htfab/breakout-ttgf0p1-adapter/README.md

# Tiny Tapeout GF 0p1 COB to ETR adapter PCB

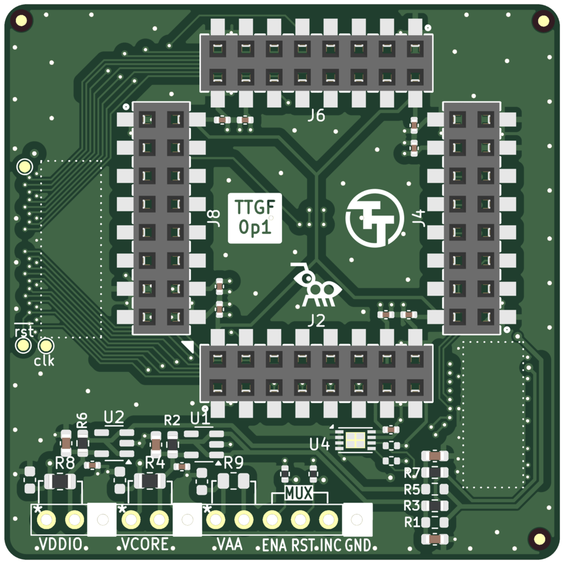
[picture p1: images/top.png]
&emsp;
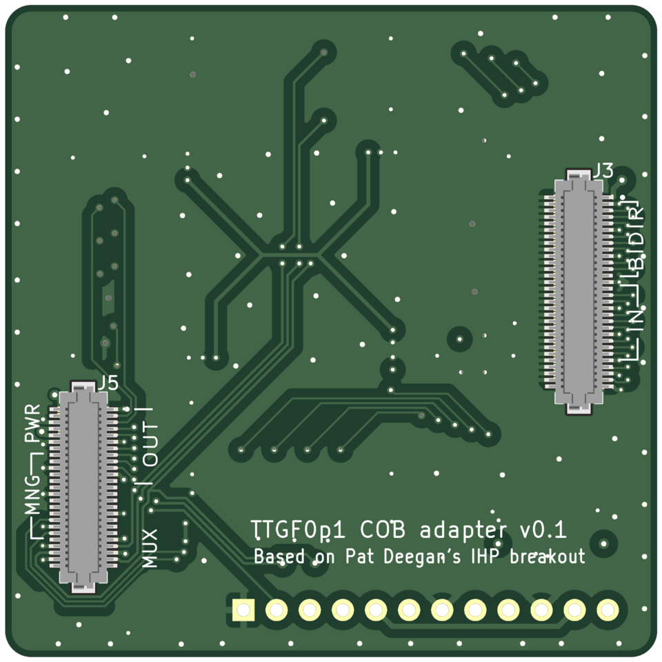
[picture p2: images/bottom.png]
