htfab/breakout-ttgf0p1-adapter/production/bom.csv

Designator | Footprint | Quantity | Value | LCSC Part #
C1, C2, C5, C6 | 0603 | 4 | 10uF
C10, C11, C12, C13, C14, C15, C16, C17 | 0402 | 8 | 1uF | CL05A105KO5NNNC
C18, C3, C7 | 0402 | 3 | 100nF | C100072
J2, J4, J6, J8 | HDR-SMD_16P-P2.54-V-F-R2-C8-LS7.2_H5.0 | 4 | Conn_02x08_Odd_Even | C42163136
J3 | HRS_DF12NB-60DS-0.5V_51 | 1 | DF12NB-60DS-0.5V_51 | C5137127
J5 | HRS_DF12NB-50DS-0.5V_51 | 1 | DF12NB-50DS-0.5V_51 | C2858672
R10, R11 | 0402 | 2 | 1kΩ | C11702
R2, R3, R6, R7 | 0603 | 4 | 0Ω | C21189
R4, R8 | 0805 | 2 | 0Ω | C17477
