htfab/breakout-ttgf0p1-adapter/breakout-ttgf0p1-adapter.kicad_sch

## KiCad design breakout-ttgf0p1-adapter.kicad_sch (2026-04-04)

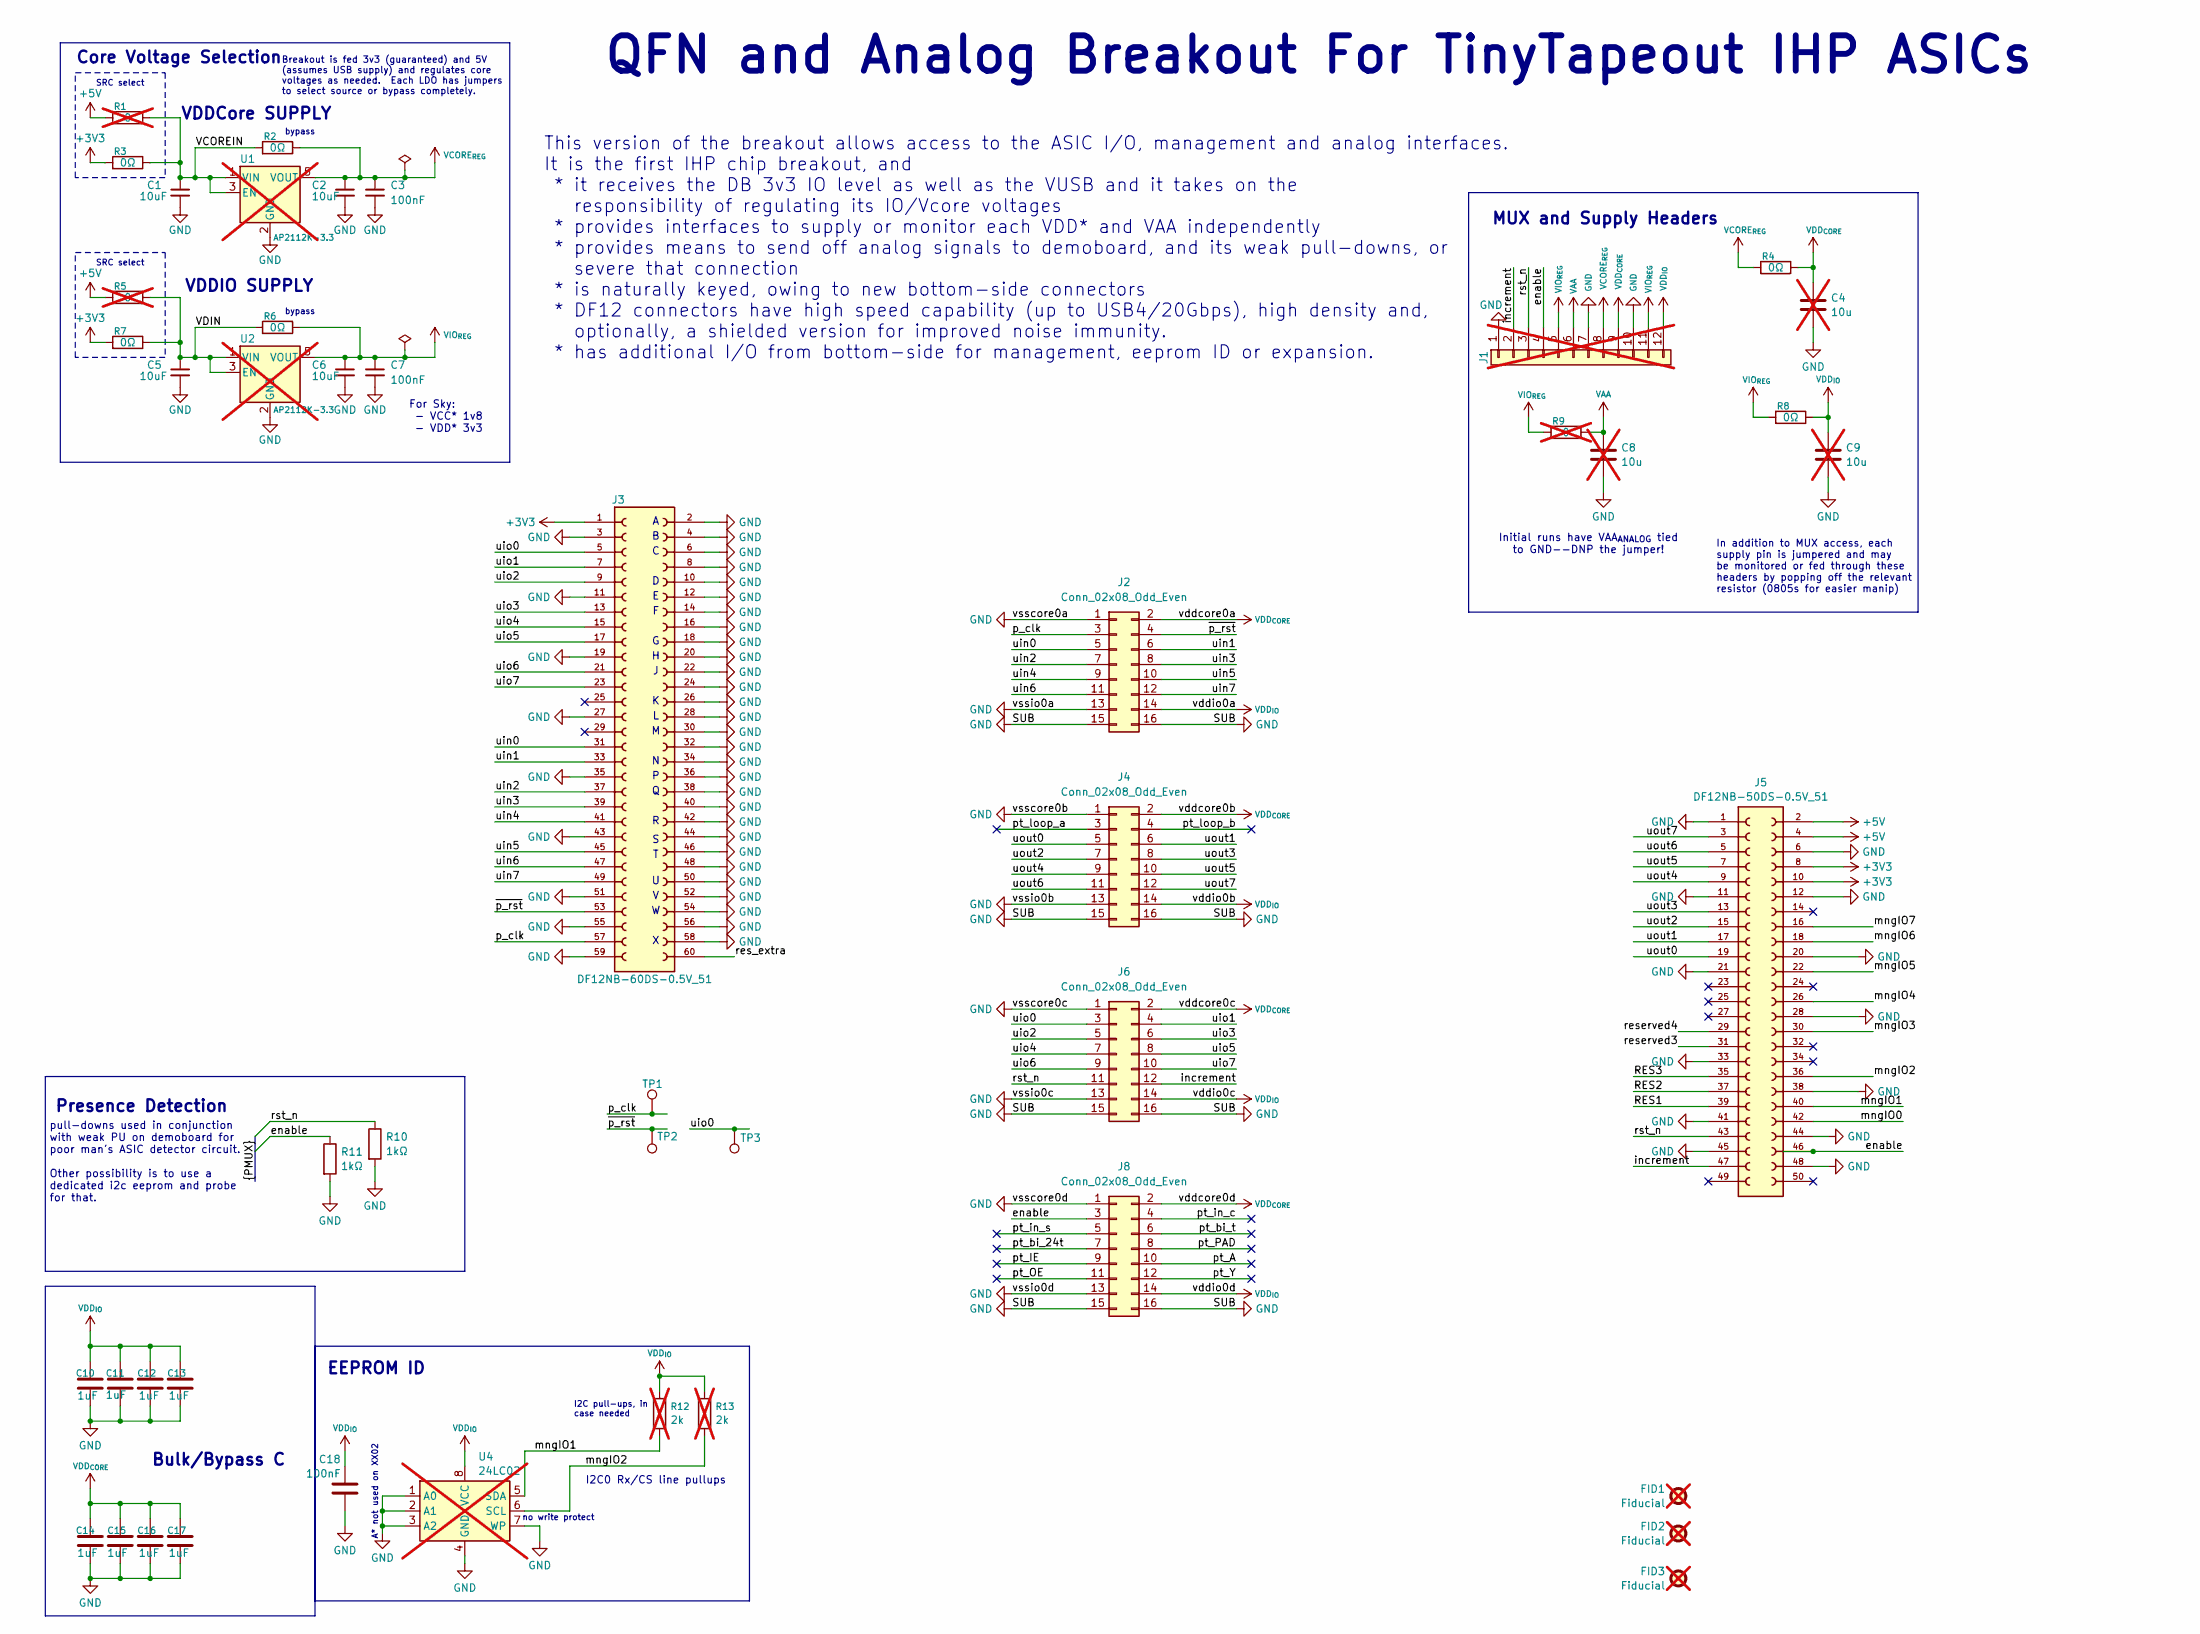
[picture p3: schematic breakout-ttgf0p1-adapter.kicad_sch]

Parts:
C1, C5: 10uF; C_0603_1608Metric; MPN_ALT LMK212AB7106MG-T
C2, C6: 10uF; C_0603_1608Metric; MPN_ALT C0603C105K4RAC7411
C3, C7, C18: 100nF; C_0402_1005Metric; MPN CL05A104KA5NNNC; LCSC C100072
C4, C8, C9: 10uF; C_0603_1608Metric; MPN GRT188R61H105KE13D; DigikeyPN 490-12330-1-ND; not fitted
C10, C11, C12, C13, C14, C15, C16, C17: 1uF; C_0402_1005Metric; MPN CL05A105KO5NNNC; DigikeyPN 1276-1067-1-ND
FID1, FID2, FID3: Fiducial; Fiducial_1mm_Mask2mm; not fitted
J1: Conn_01x12; PinHeader_1x12_P2.54mm_Vertical; not fitted
J2, J4, J6, J8: Conn_02x08_Odd_Even; HDR-SMD_16P-P2.54-V-F-R2-C8-LS7.2_H5.0
J3: DF12NB-60DS-0.5V_51; HRS_DF12NB-60DS-0.5V_51; MPN DF12NB-60DS-0.5V(51); DigikeyPN 26-DF12NB-60DS-0.5V(51)CT-ND
J5: DF12NB-50DS-0.5V_51; HRS_DF12NB-50DS-0.5V_51; MPN DF12NB-50DS-0.5V(51); DigikeyPN 26-DF12NB-50DS-0.5V(51)CT-ND
R1, R5: 0; R_0603_1608Metric; MPN CRG0603ZR; DigikeyPN A106051CT-ND; not fitted
R2, R3, R6, R7: 0Ω; R_0603_1608Metric; MPN CRG0603ZR; DigikeyPN A106051CT-ND
R4, R8: 0Ω; R_0805_2012Metric; MPN RC0805JR-100RL; DigikeyPN 13-RC0805JR-100RLCT-ND
R9: 0; R_0805_2012Metric; MPN RC0805JR-100RL; DigikeyPN 13-RC0805JR-100RLCT-ND; not fitted
R10, R11: 1kΩ; R_0402_1005Metric; MPN CR0402-FX-1001GLF; LCSC C11702
R12, R13: 2k; R_0402_1005Metric; MPN RC0402FR-072KL; DigikeyPN 311-2KLRCT-ND; not fitted
TP1, TP2, TP3: TestPoint; TestPoint_Pad_D1.0mm
U1, U2: AP2112K-3.3; SOT-23-5; MPN AP2112K-3.3TRG1; DigikeyPN AP2112K-3.3TRG1DICT-ND; not fitted
U4: 24LC02; DFN-8-1EP_3x2mm_P0.5mm_EP1.75x1.45mm; MPN 24LC02BT-I/MC; DigikeyPN 24LC02BT-I/MCCT-ND; not fitted

Connections:
+3V3: J3.1, J5.8, J5.10, R3.1, R7.1
+5V: J5.2, J5.4, R1.1, R5.1
GND: C1.2, C2.2, C3.2, C4.2, C5.2, C6.2, C7.2, C8.2, C9.2, C10.2, C11.2, C12.2, C13.2, C14.2, C15.2, C16.2, C17.2, C18.1, J1.1, J1.7, J1.10, J2.1, J2.13, J2.15, J2.16, J3.2, J3.3, J3.4, J3.6, J3.8, J3.10, J3.11, J3.12, J3.14, J3.16, J3.18, J3.19, J3.20, J3.22, J3.24, J3.26, J3.27, J3.28, J3.30, J3.32, J3.34, J3.35, J3.36, J3.38, J3.40, J3.42, J3.43, J3.44, J3.46, J3.48, J3.50, J3.51, J3.52, J3.54, J3.55, J3.56, J3.58, J3.59, J4.1, J4.13, J4.15, J4.16, J5.1, J5.6, J5.11, J5.12, J5.20, J5.21, J5.28, J5.33, J5.38, J5.41, J5.44, J5.45, J5.48, J6.1, J6.13, J6.15, J6.16, J8.1, J8.13, J8.15, J8.16, R10.2, R11.2, U1.2 (GND), U2.2 (GND), U4.1 (A0), U4.2 (A1), U4.3 (A2), U4.4 (GND), U4.7 (WP)
RES1: J5.39
RES2: J5.37
RES3: J5.35
VAA: C8.1, J1.6, R9.2
VCOREIN: C1.1, R1.2, R2.1, R3.2, U1.1 (VIN), U1.3 (EN)
VCORE_{REG}: C2.1, C3.1, J1.8, R2.2, R4.1, U1.5 (VOUT)
VDD_{CORE}: C4.1, C14.1, C15.1, C16.1, C17.1, J1.9, J2.2, J4.2, J6.2, J8.2, R4.2
VDD_{IO}: C9.1, C10.1, C11.1, C12.1, C13.1, C18.2, J1.12, J2.14, J4.14, J6.14, J8.14, R8.2, R12.1, R13.1, U4.8 (VCC)
VDIN: C5.1, R5.2, R6.1, R7.2, U2.1 (VIN), U2.3 (EN)
VIO_{REG}: C6.1, C7.1, J1.5, J1.11, R6.2, R8.1, R9.1, U2.5 (VOUT)
enable: J1.4, J5.46, J8.3, R11.1
increment: J1.2, J5.47, J6.12
mngIO0: J5.42
mngIO1: J5.40, R12.2, U4.5 (SDA)
mngIO2: J5.36, R13.2, U4.6 (SCL)
mngIO3: J5.30
mngIO4: J5.26
mngIO5: J5.22
mngIO6: J5.18
mngIO7: J5.16
p_clk: J2.3, J3.57, TP1.1
pt_A: J8.10
pt_IE: J8.9
pt_OE: J8.11
pt_PAD: J8.8
pt_Y: J8.12
pt_bi_24t: J8.7
pt_bi_t: J8.6
pt_in_c: J8.4
pt_in_s: J8.5
pt_loop_a: J4.3
pt_loop_b: J4.4
res_extra: J3.60
reserved3: J5.31
reserved4: J5.29
rst_n: J1.3, J5.43, J6.11, R10.1
uin0: J2.5, J3.31
uin1: J2.6, J3.33
uin2: J2.7, J3.37
uin3: J2.8, J3.39
uin4: J2.9, J3.41
uin5: J2.10, J3.45
uin6: J2.11, J3.47
uin7: J2.12, J3.49
uio0: J3.5, J6.3, TP3.1
uio1: J3.7, J6.4
uio2: J3.9, J6.5
uio3: J3.13, J6.6
uio4: J3.15, J6.7
uio5: J3.17, J6.8
uio6: J3.21, J6.9
uio7: J3.23, J6.10
uout0: J4.5, J5.19
uout1: J4.6, J5.17
uout2: J4.7, J5.15
uout3: J4.8, J5.13
uout4: J4.9, J5.9
uout5: J4.10, J5.7
uout6: J4.11, J5.5
uout7: J4.12, J5.3
~p_rst: J2.4, J3.53, TP2.1

Notes on the sheet:
Presence Detection
Bulk/Bypass C
I2C pull-ups, in case needed
pull-downs used in conjunction with weak PU on demoboard for poor man's ASIC detector circuit. Other possibility is to use a dedicated i2c eeprom and probe for that.
For Sky: - VCC* 1v8 - VDD* 3v3
Breakout is fed 3v3 (guaranteed) and 5V (assumes USB supply) and regulates core voltages as needed. Each LDO has jumpers to select source or bypass completely.
I2C0 Rx/CS line pullups
A* not used on XX02
MUX and Supply Headers
bypass
Initial runs have VAA_{ANALOG} tied to GND--DNP the jumper!
VDDCore SUPPLY
SRC select
In addition to MUX access, each supply pin is jumpered and may be monitored or fed through these headers by popping off the relevant resistor (0805s for easier manip)
VDDIO SUPPLY
no write protect
This version of the breakout allows access to the ASIC I/O, management and analog interfaces. It is the first IHP chip breakout, and * it receives the DB 3v3 IO level as well as the VUSB and it takes on the responsibility of regulating its IO/Vcore voltages * provides interfaces to supply or monito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
Core Voltage Selection
EEPROM ID
QFN and Analog Breakout For TinyTapeout IHP ASICs
