htfab/breakout-ttgf0p1-adapter/(commit log)

2026-03-18 initial version
    [breakout-ttgf0p1-adapter.kicad_pcb, breakout-ttgf0p1-adapter.kicad_sch]
2026-03-18 remove cob symbol & footprint
2026-03-19 add tillitis logo
    [breakout-ttgf0p1-adapter.kicad_pcb]
2026-03-19 don't remove duplicate track
    [breakout-ttgf0p1-adapter.kicad_pcb]
2026-03-19 add board images
2026-03-19 add production files
    [bom.csv, designators.csv, positions.csv]
2026-03-19 update metadata
    [breakout-ttgf0p1-adapter.kicad_pcb]
2026-03-19 exclude DNP components from BOM
    [bom.csv]
2026-04-04 replace THT headers with SMT ones & reroute
    [bom.csv, breakout-ttgf0p1-adapter.kicad_pcb, breakout-ttgf0p1-adapter.kicad_sch, designators.csv, positions.csv]
2026-04-04 fix invalid layer name in JLC2KiCad footprint
    [breakout-ttgf0p1-adapter.kicad_pcb]
2026-04-04 add part number for headers
    [bom.csv, breakout-ttgf0p1-adapter.kicad_pcb]
2026-04-04 update component fields
    [bom.csv, breakout-ttgf0p1-adapter.kicad_pcb, breakout-ttgf0p1-adapter.kicad_sch]
