htfab/breakout-ttgf0p1-adapter/(notices)

Notices in the files:
breakout-ttgf0p1-adapter.kicad_sch:
(C) 2026 Pat Deegan
